sanine-a/iowa-rover/README.md

iowa-rover
==========

hardware & software for the new Iowa Mars rover exhibit.
