sanine-a/iowa-rover/kiosk/code/README.md

# kiosk/code

This folder contains three Arduino sketches used on the rover electronics.

  * `irkiosk-i2c-reset`: sketch for the ATTiny85 used to power-cycle the RFID modules
  * `irkiosk-main`: main sketch, for the Arduino Mega
  * `irkiosk-rfid-attiny`: sketch for the ATTiny84s on the RFID modules
