sanine-a/iowa-rover/rover/electronics/iowa-rover/README.md

Iowa Science Rover - Rover Controller
=====================================

The main controller board for the SMM revision of the Iowa Science Rover.

The Metro Mini listens for commands from the kiosk via the radio transceiver, and then executes
the received commands via the motors. The switch allows the controller to choose which kiosk it
listens to, and the trimpot allows maintenance technicians to correct for any directional drift due
to motor wear over time.

Parts
-----

 * [TB6612 Motor Driver](https://www.adafruit.com/product/2448)
 * [RFM69HCW Transceiver](https://www.adafruit.com/product/3070)
 * [Metro Mini v2](https://www.adafruit.com/product/2590)
 * [2k Trimpot](https://www.digikey.com/en/products/detail/bourns-inc/3352T-1-202LF/1088345)
 * [SPDT Switch](https://www.digikey.com/en/products/detail/bourns-inc/3352T-1-202LF/1088345)
 * [USB-C Power Connector](https://www.adafruit.com/product/4907)
 * [Screw Terminals](https://www.digikey.com/en/products/detail/molex/0398800302/2421325)
 * [Motors](https://www.adafruit.com/product/3802)
