sanine-a/iowa-rover/kiosk/electronics/iowa-rover-kiosk-lamps/iowa-rover-kiosk-lamps.pdf

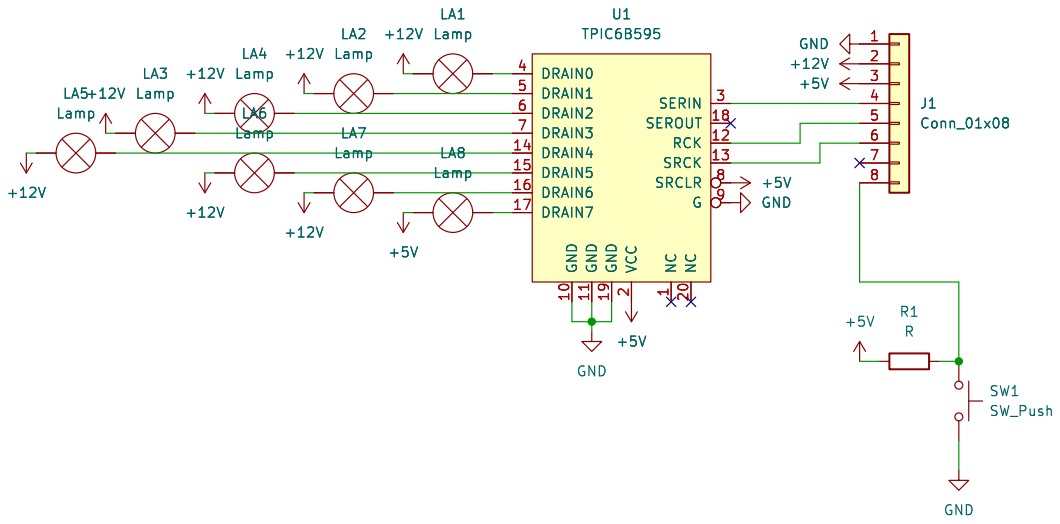
[picture p3: page 1]

1 GND 10 GND 11 RCK 12 SRCK DRAIN4 13

Id: 1/1 Title: Iowa Science Rover Kiosk - Lamps Board
