sanine-a/iowa-rover/kiosk/electronics/iowa-rover-kiosk-main/iowa-rover-kiosk-main.pdf

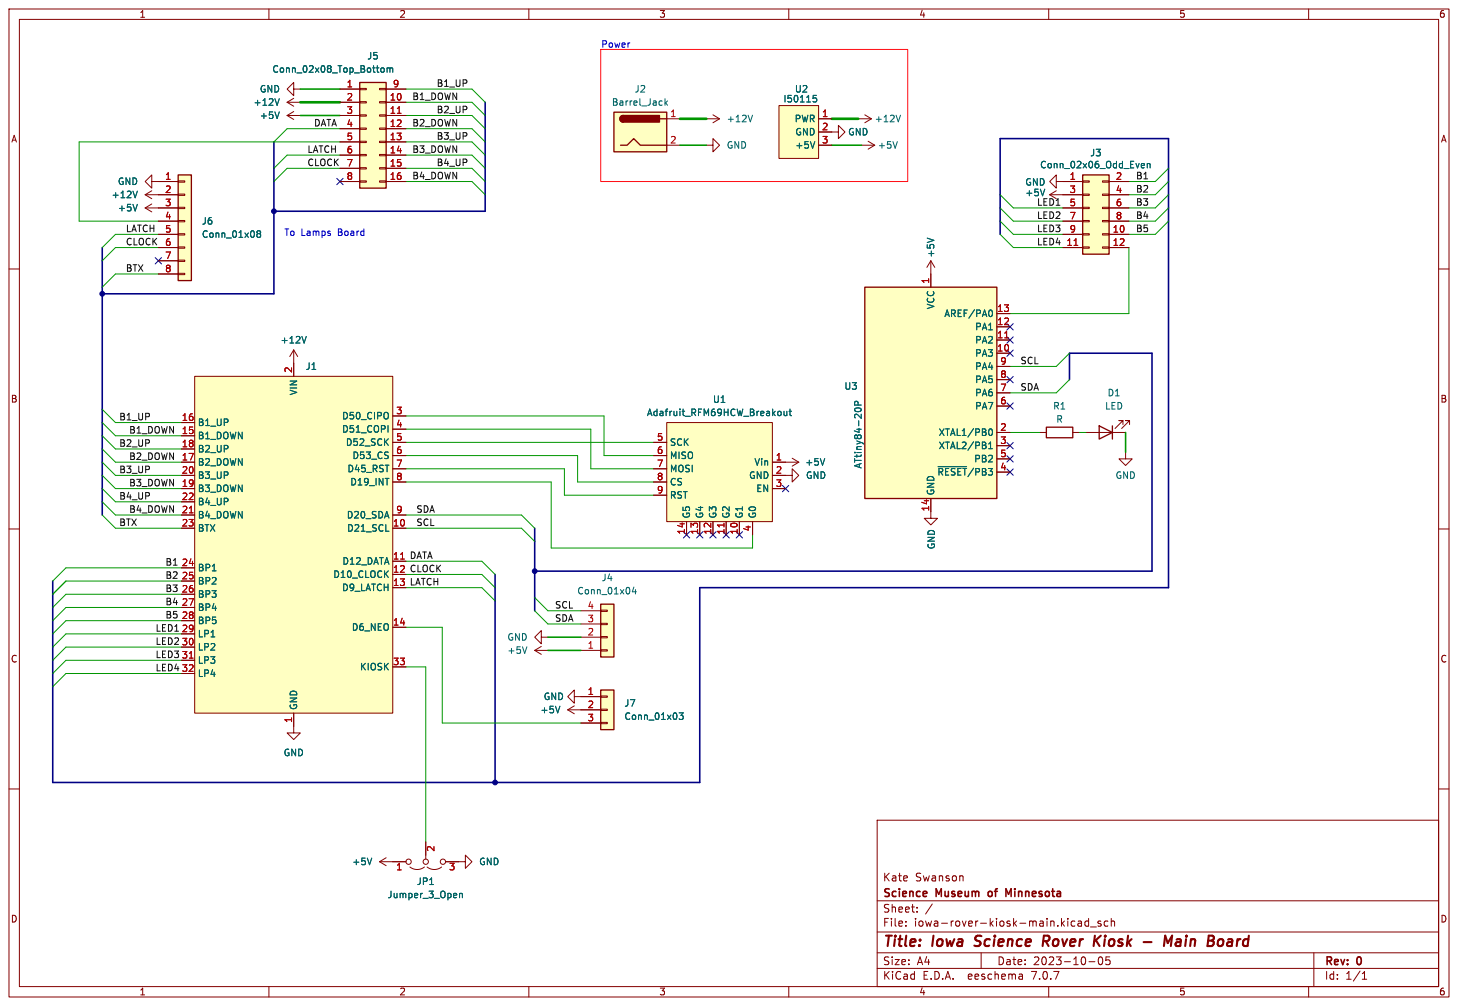
[picture p4: page 1]

4 SCK 5 MISO 6 MOSI 7 CS 8 RST 9 U1 Adafruit_RFM69HCW_Breakout +12V GND

4 SCK 5 MISO 6 MOSI 7 CS 8 RST 9

Id: 1/1 Title: Iowa Science Rover Kiosk - Main Board
