sanine-a/iowa-rover/kiosk/electronics/iowa-rover-kiosk-mega-adapter/iowa-rover-kiosk-mega-adapter.pdf

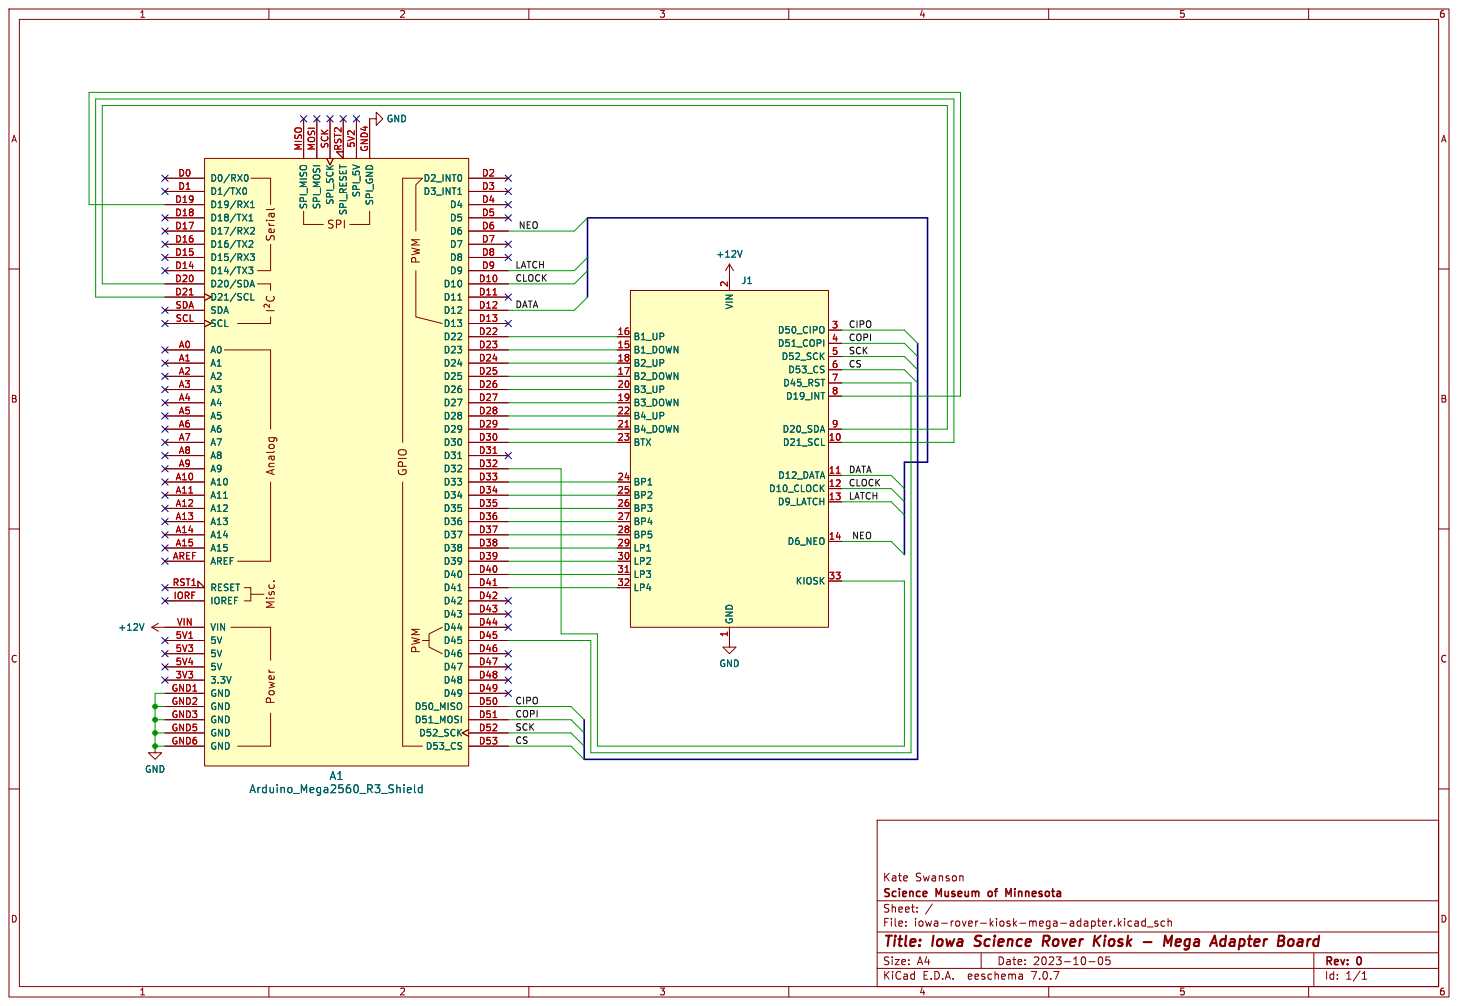
[picture p5: page 1]

Id: 1/1 Title: Iowa Science Rover Kiosk - Mega Adapter Board
