sanine-a/iowa-rover/kiosk/electronics/iowa-rover-kiosk-programmer/iowa-rover-kiosk-programmer.pdf

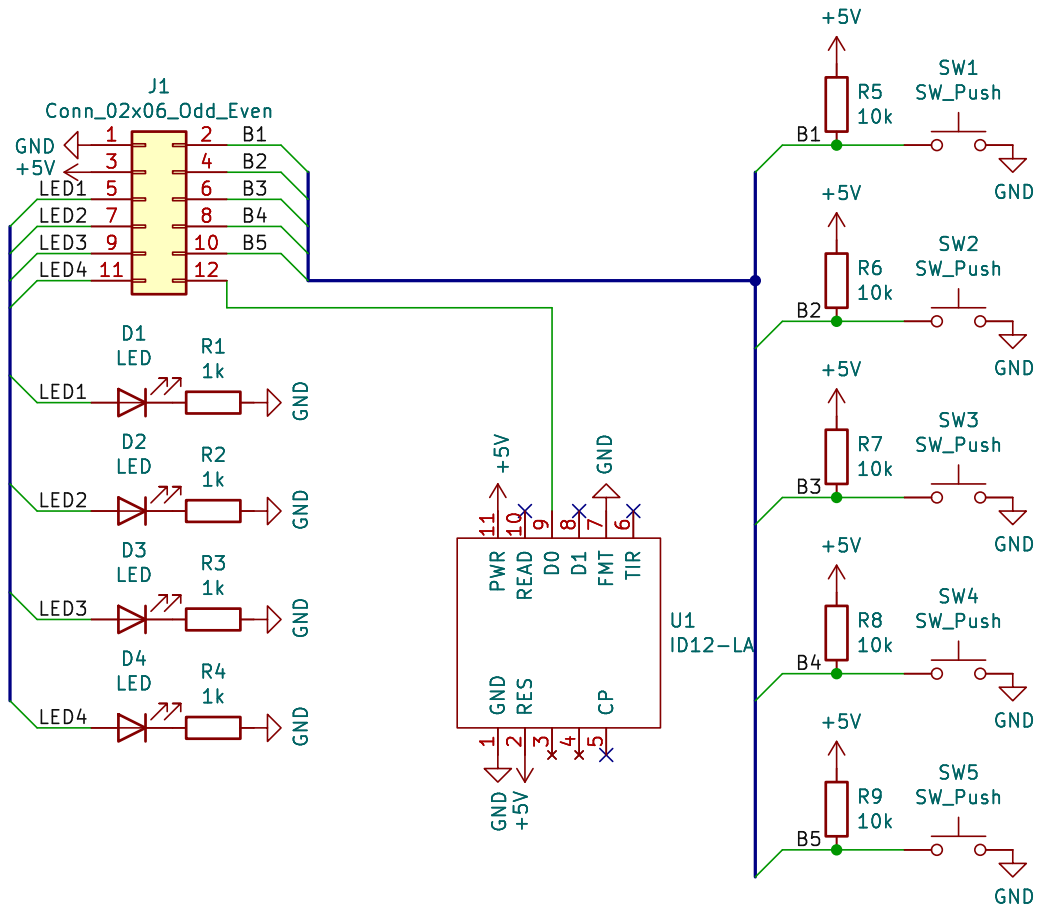
[picture p6: page 1]

Id: 1/1 Title: Iowa Science Rover Kiosk - RFID Programmer Board
