sanine-a/iowa-rover/kiosk/electronics/iowa-rover-kiosk-rfid/iowa-rover-kiosk-rfid.pdf

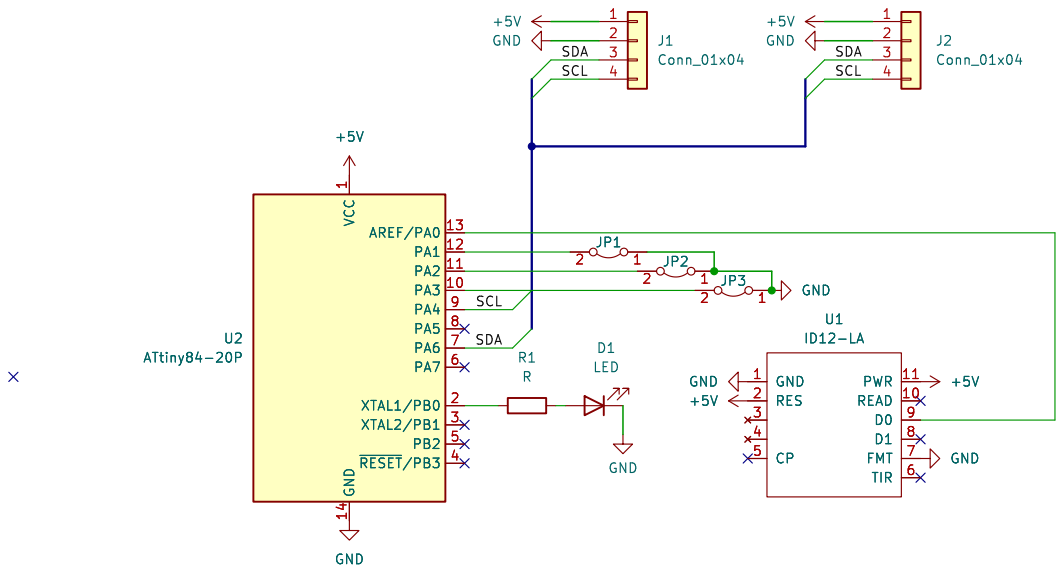
[picture p7: page 1]

1 PA3 10 PA2 11 PA1 12 AREF/PA0 13 GND 14 XTAL1/PB0 2 XTAL2/PB1 3 ~{RESET}/PB34 PB2 5 PA7 6 PA6 7 PA5 8 PA4 9 U2 ATtiny84-20P GND GND

1 PA3 10 PA2 11 PA1 12 AREF/PA0 13 GND 14 XTAL1/PB0 2 XTAL2/PB1 3 ~{RESET}/PB34 PB2 5 PA7 6 PA6 7 PA5 8 PA4 9 GND

Id: 1/1 Title: Iowa Rover Kiosk - RFID Board
