sanine-a/iowa-rover/rover/electronics/iowa-rover/iowa-rover.pdf

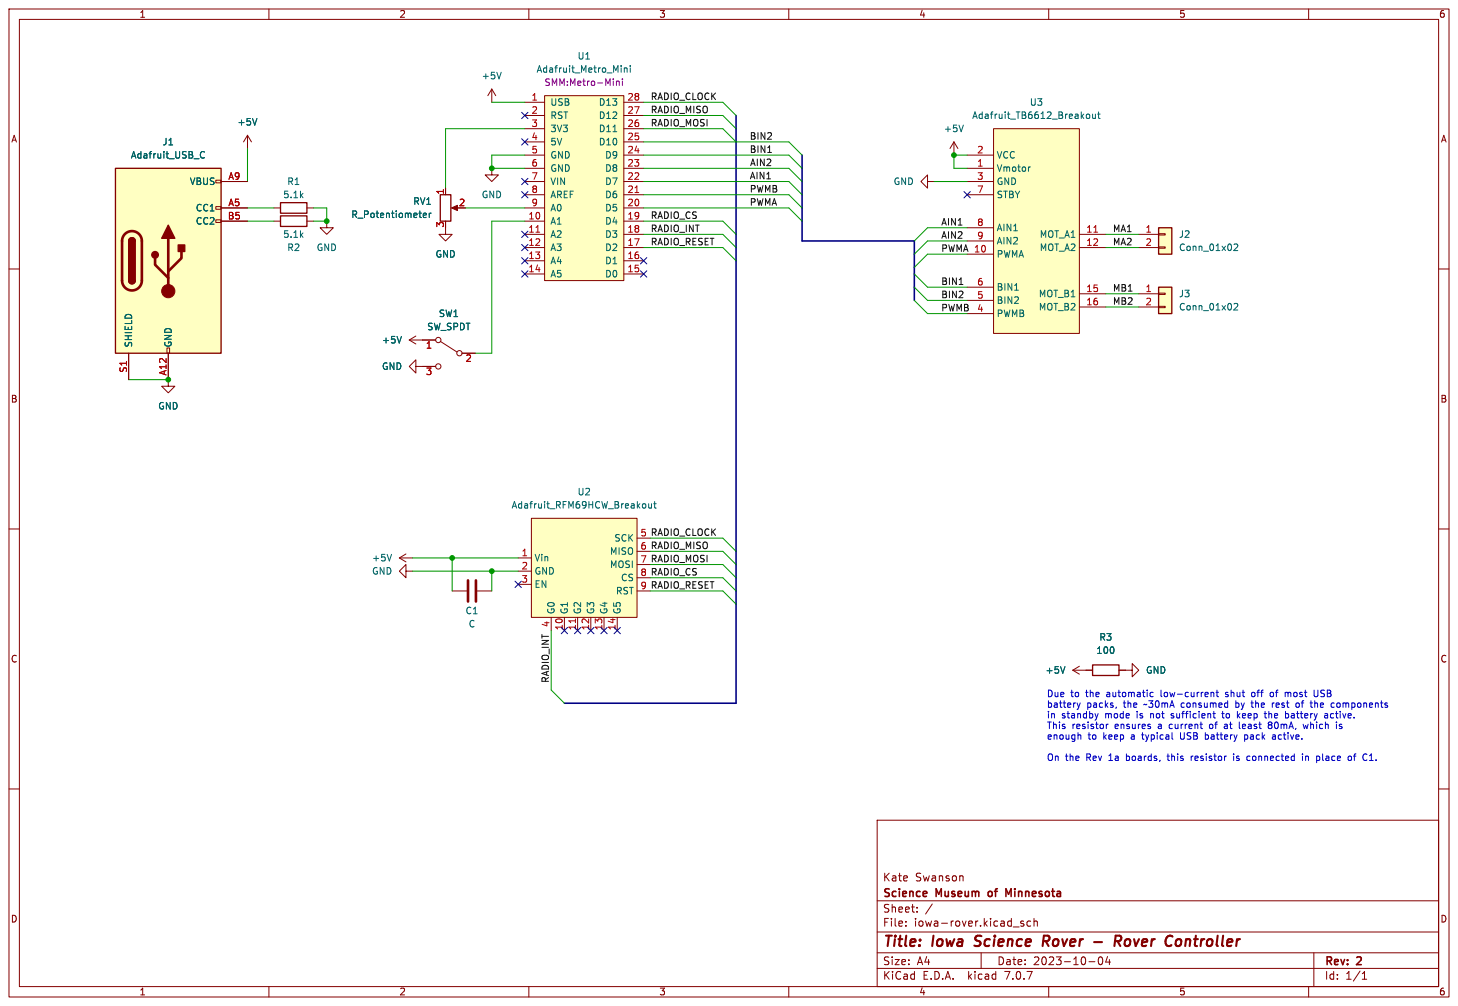
[picture p8: page 1]

4 SCK 5 MISO 6 MOSI 7 CS 8 RST 9 U2 Adafruit_RFM69HCW_Breakout BIN1 RADIO_MISO
