sanine-a/iowa-rover/kiosk/electronics/iowa-rover-kiosk-power-cycler/iowa-rover-kiosk-power-cycler.kicad_pcb

## KiCad design kiosk/electronics/iowa-rover-kiosk-power-cycler/iowa-rover-kiosk-power-cycler.kicad_pcb (2023-10-26)

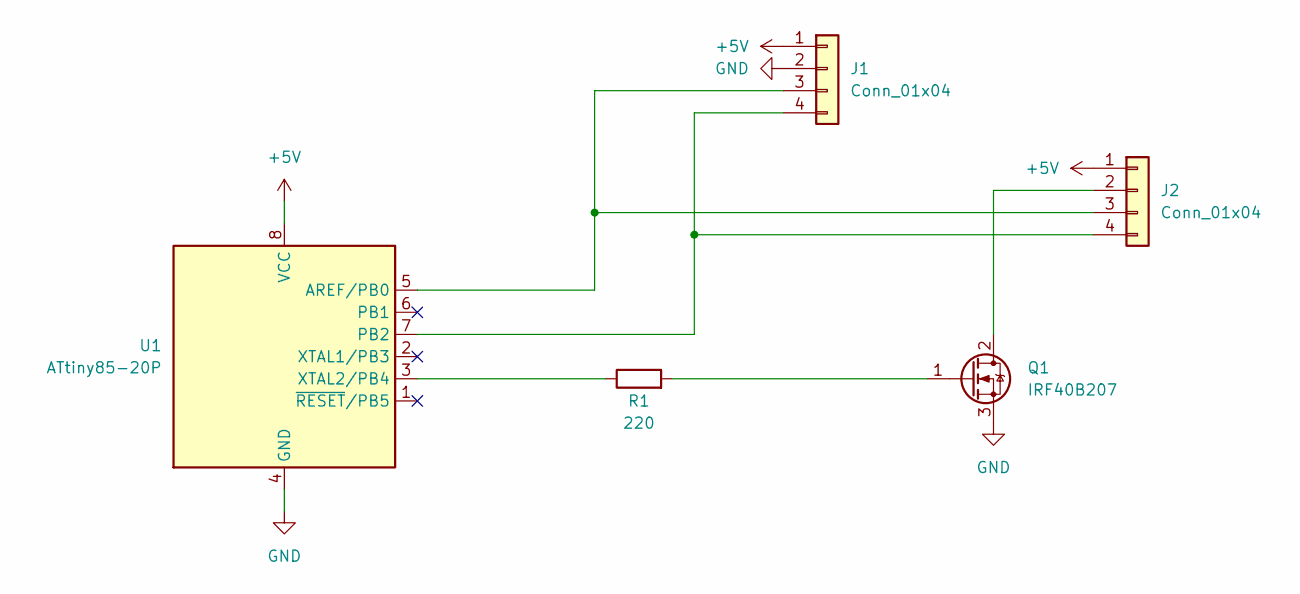
[picture p9: schematic iowa-rover-kiosk-power-cycler.kicad_sch]

Parts:
J1, J2: Conn_01x04; Molex_KK-254_AE-6410-04A_1x04_P2.54mm_Vertical
Q1: IRF40B207; TO-220-3_Vertical
R1: 220; R_Axial_DIN0207_L6.3mm_D2.5mm_P7.62mm_Horizontal
U1: ATtiny85-20P; DIP-8_W7.62mm

Connections:
+5V: J1.1, J2.1, U1.8 (VCC)
GND: J1.2, Q1.3 (S), U1.4 (GND)
unnamed: J1.3, J2.3, U1.5 (AREF/PB0)
unnamed: J1.4, J2.4, U1.7 (PB2)
unnamed: J2.2, Q1.2 (D)
unnamed: Q1.1 (G), R1.2
unnamed: R1.1, U1.3 (XTAL2/PB4)

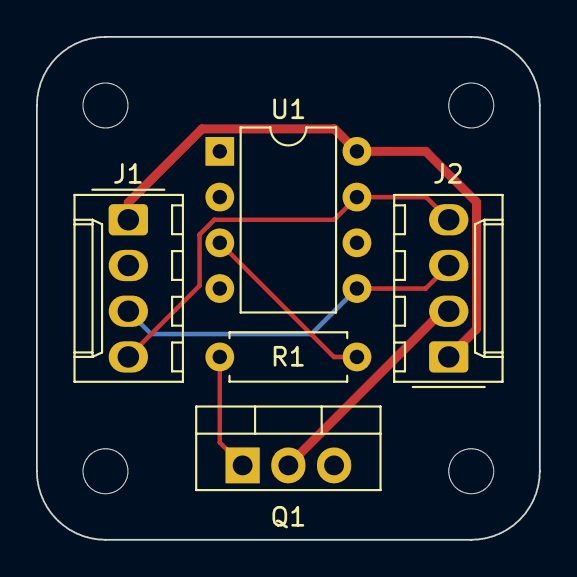
[picture p10: board iowa-rover-kiosk-power-cycler.kicad_pcb from above]

Board: 2 copper layers, 27.9 x 27.9 mm, 5 parts (0 on the bottom side), 7 nets.
