sanine-a/iowa-rover/rover/electronics/iowa-rover/iowa-rover.kicad_pcb

## KiCad design rover/electronics/iowa-rover/iowa-rover.kicad_pcb (2023-10-03)

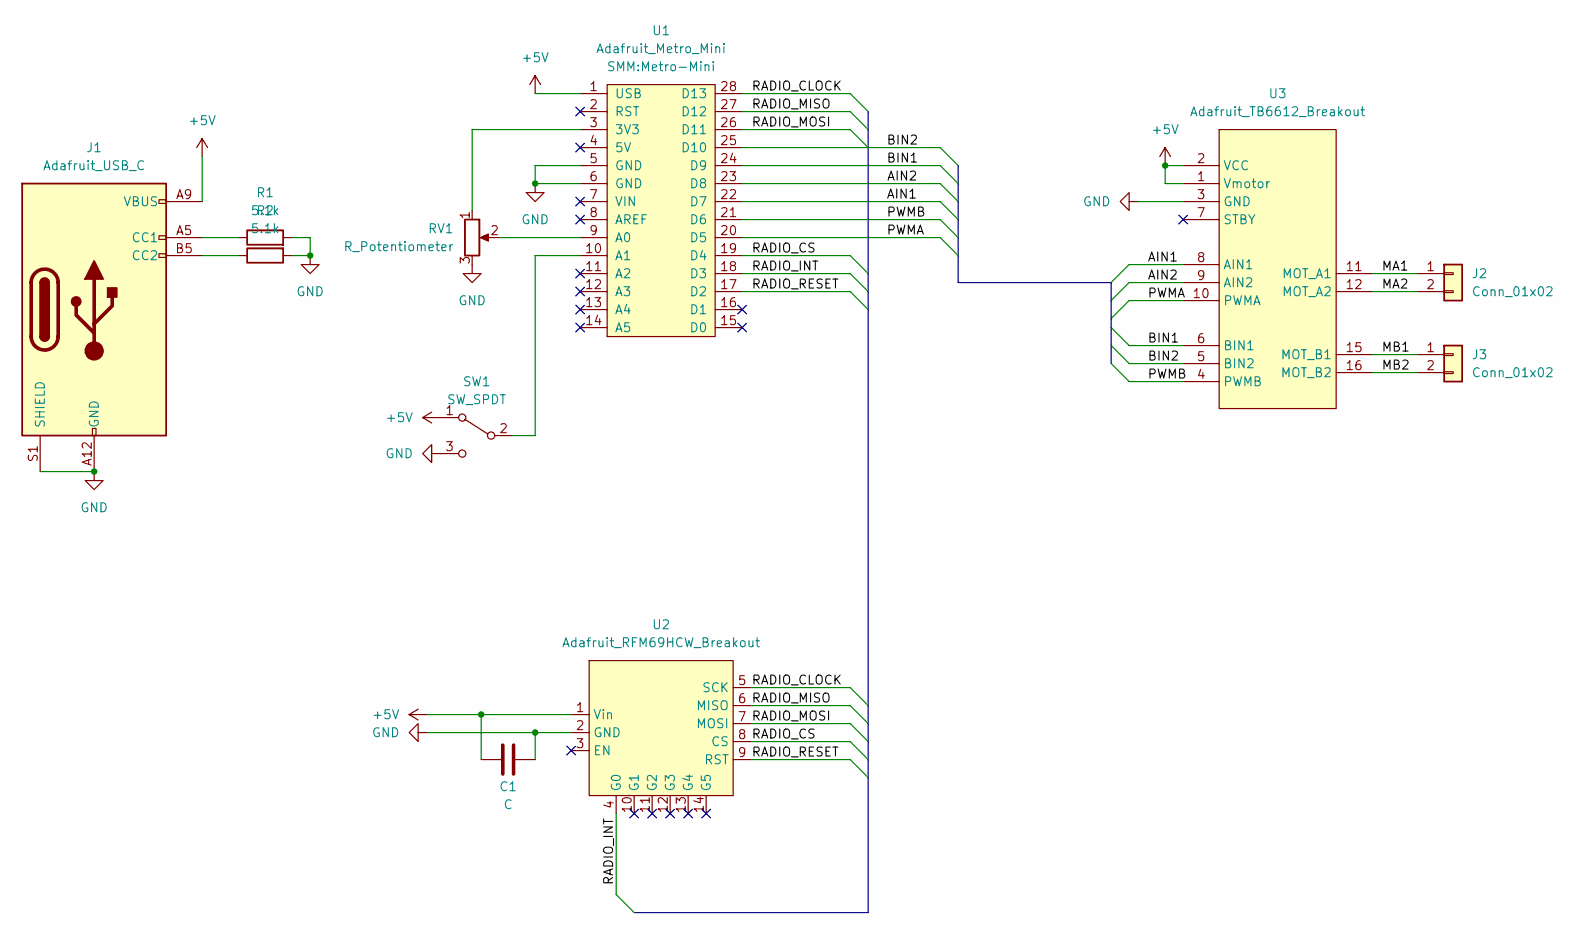
[picture p11: schematic iowa-rover.kicad_sch]

Parts:
C1: C; C_Disc_D4.3mm_W1.9mm_P5.00mm
J1: Adafruit_USB_C
J2, J3: Conn_01x02; TerminalBlock-2_P5.08mm_small
R1, R2: 5.1k; Resistor_L6.3mm_D2.5mm_P10.16mm_Horizontal
RV1: R_Potentiometer; Rover_Trimpot
SW1: SW_SPDT; SW_EG1218
U1: Adafruit_Metro_Mini; Metro-Mini
U2: Adafruit_RFM69HCW_Breakout; Adafruit RFM69HCW Breakout
U3: Adafruit_TB6612_Breakout

Connections:
+5V: C1.1, J1.A9 (VBUS), J1.B9 (VBUS), SW1.1 (A), U1.1 (USB), U2.1 (Vin), U3.1 (Vmotor), U3.2 (VCC)
/AIN1: U1.22 (D7), U3.8 (AIN1)
/AIN2: U1.23 (D8), U3.9 (AIN2)
/BIN1: U1.24 (D9), U3.6 (BIN1)
/BIN2: U1.25 (D10), U3.5 (BIN2)
/MA1: J2.1, U3.11 (MOT_A1)
/MA2: J2.2, U3.12 (MOT_A2)
/MB1: J3.1, U3.15 (MOT_B1)
/MB2: J3.2, U3.16 (MOT_B2)
/PWMA: U1.20 (D5), U3.10 (PWMA)
/PWMB: U1.21 (D6), U3.4 (PWMB)
/RADIO_CLOCK: U1.28 (D13), U2.5 (SCK)
/RADIO_CS: U1.19 (D4), U2.8 (CS)
/RADIO_INT: U1.18 (D3), U2.4 (G0)
/RADIO_MISO: U1.27 (D12), U2.6 (MISO)
/RADIO_MOSI: U1.26 (D11), U2.7 (MOSI)
/RADIO_RESET: U1.17 (D2), U2.9 (RST)
GND: C1.2, J1.A12 (GND), J1.B12 (GND), J1.S1 (SHIELD), R1.2, R2.2, RV1.3, SW1.3 (C), U1.5 (GND), U1.6 (GND), U2.2 (GND), U3.3 (GND), U3.13 (GND), U3.14 (GND)
unnamed: J1.A5 (CC1), R1.1
unnamed: J1.B5 (CC2), R2.1
unnamed: SW1.2 (B), U1.10 (A1)
unnamed: RV1.1, U1.3 (3V3)
unnamed: RV1.2, U1.9 (A0)

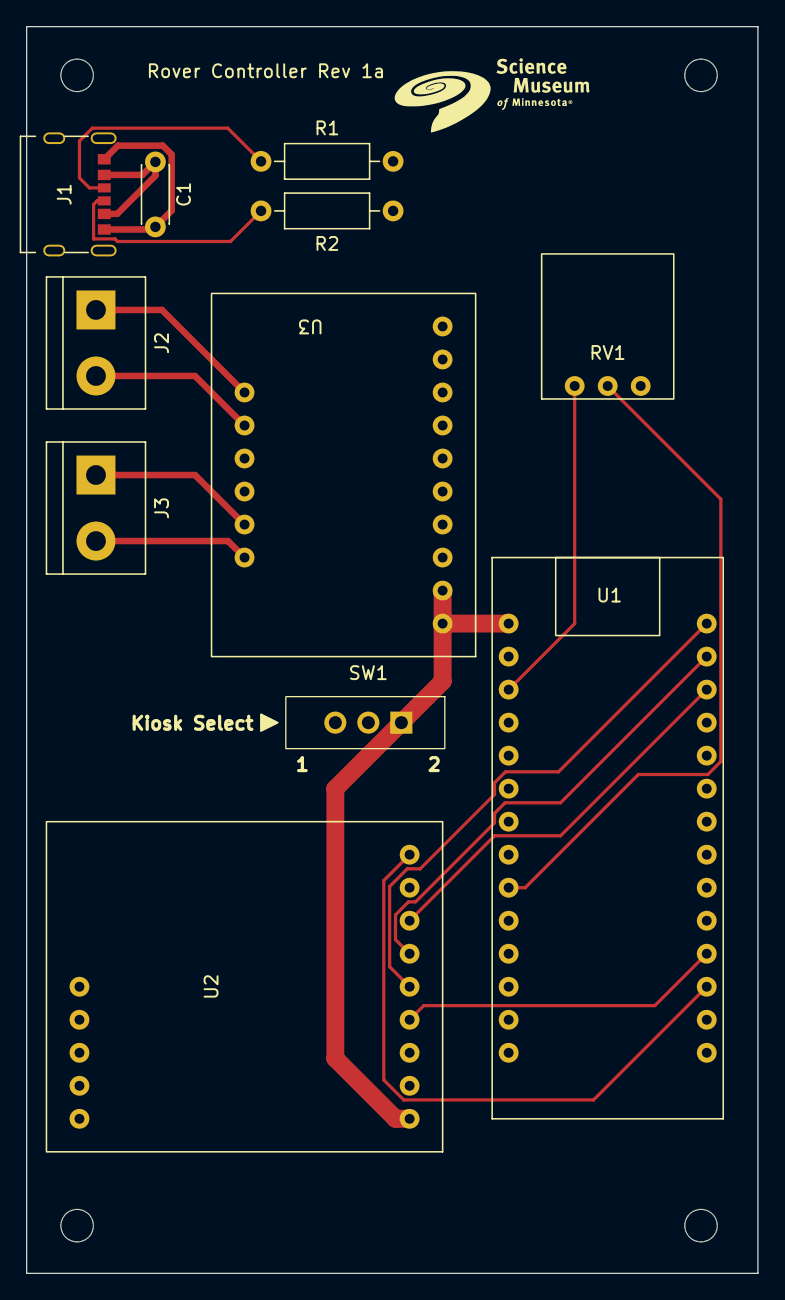
[picture p12: board iowa-rover.kicad_pcb from above]

Board: 4 copper layers, 56.3 x 95.9 mm, 11 parts (0 on the bottom side), 23 nets.
