sanine-a/iowa-rover/kiosk/electronics/iowa-rover-kiosk-rfid/iowa-rover-kiosk-rfid.kicad_pcb

## KiCad design kiosk/electronics/iowa-rover-kiosk-rfid/iowa-rover-kiosk-rfid.kicad_pcb (2023-10-03)

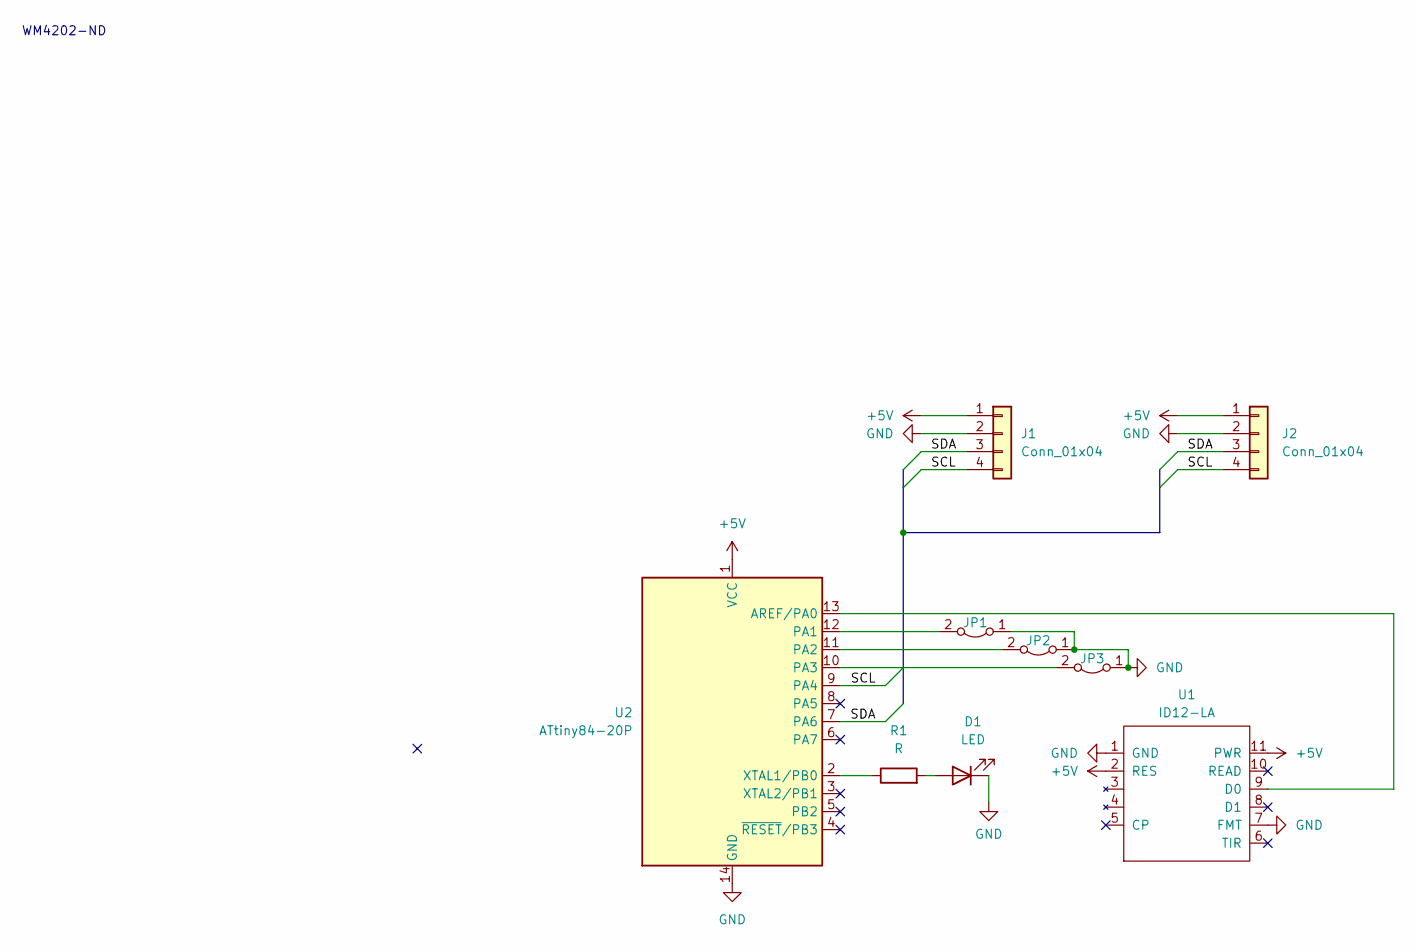
[picture p13: schematic iowa-rover-kiosk-rfid.kicad_sch]

Parts:
D1: LED; LED_D3.0mm
J1, J2: Conn_01x04; KK-1x04
JP1, JP2, JP3: Jumper_2_Bridged; SolderJumper-2_P1.3mm_Bridged_RoundedPad1.0x1.5mm
R1: R; Resistor_L6.3mm_D2.5mm_P10.16mm_Horizontal
U1: ID12-LA; ID-12LA-Inverted
U2: ATtiny84-20P; DIP-14_W7.62mm

Connections:
+5V: J1.1, J2.1, U1.2 (RES), U1.11 (PWR), U2.1 (VCC)
/SCL: J1.4, J2.4, U2.9 (PA4)
/SDA: J1.3, J2.3, U2.7 (PA6)
GND: D1.1 (K), J1.2, J2.2, JP1.1 (A), JP2.1 (A), JP3.1 (A), U1.1 (GND), U1.7 (FMT), U2.14 (GND)
unnamed: D1.2 (A), R1.2
unnamed: JP1.2 (B), U2.12 (PA1)
unnamed: JP2.2 (B), U2.11 (PA2)
unnamed: JP3.2 (B), U2.10 (PA3)
unnamed: U1.9 (D0), U2.13 (AREF/PA0)
unnamed: R1.1, U2.2 (XTAL1/PB0)

Notes on the sheet:
WM4202-ND

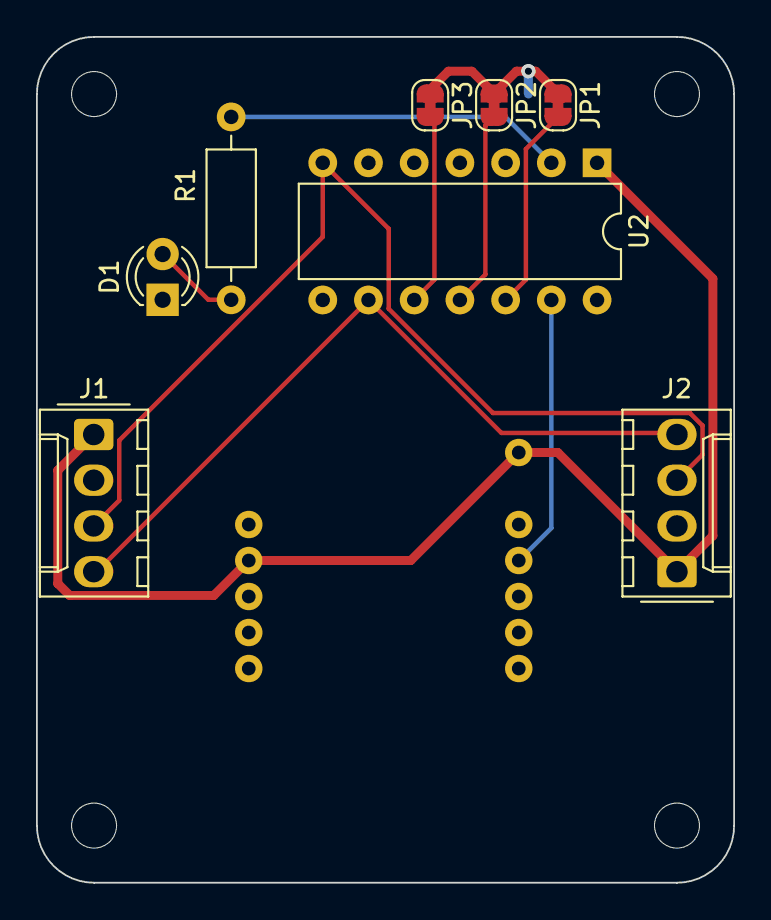
[picture p14: board iowa-rover-kiosk-rfid.kicad_pcb from above]

Board: 2 copper layers, 38.7 x 47.0 mm, 9 parts (0 on the bottom side), 10 nets.
