sanine-a/iowa-rover/kiosk/electronics/iowa-rover-kiosk-programmer/iowa-rover-kiosk-programmer.kicad_pcb

## KiCad design kiosk/electronics/iowa-rover-kiosk-programmer/iowa-rover-kiosk-programmer.kicad_pcb (2023-10-03)

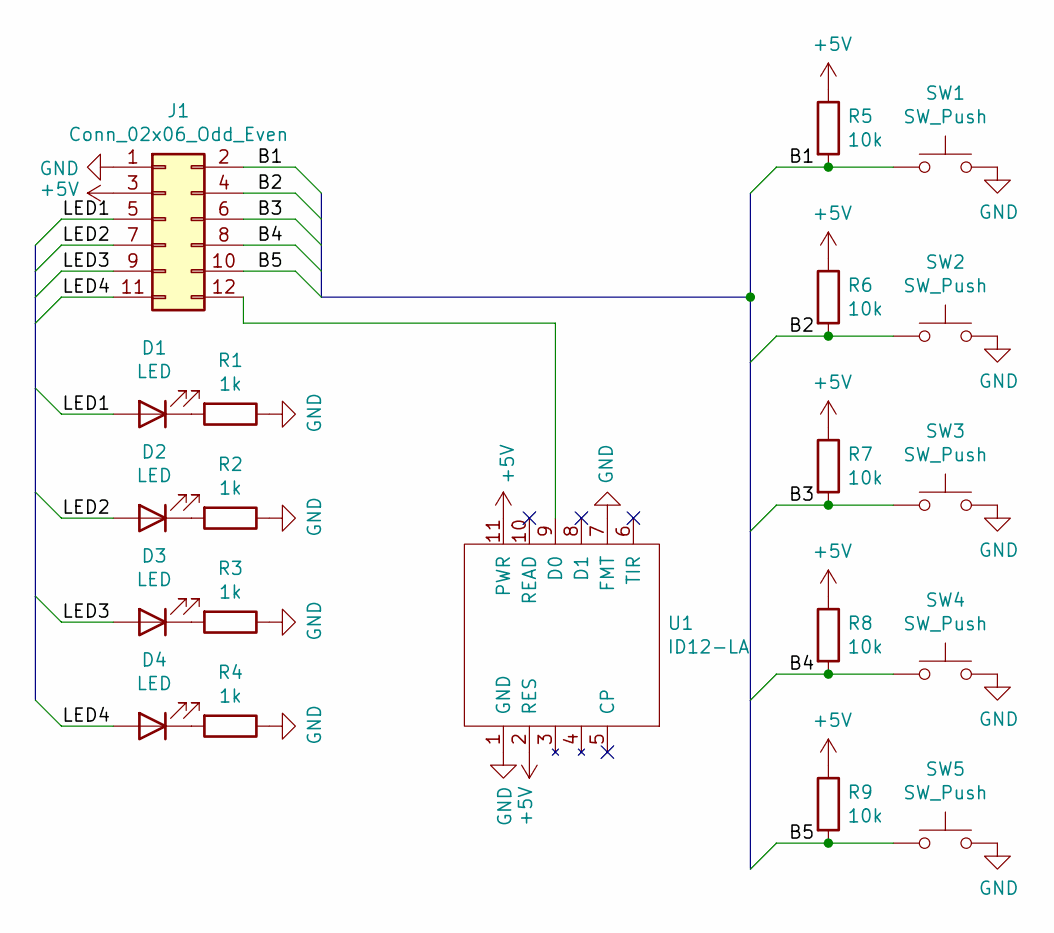
[picture p15: schematic iowa-rover-kiosk-programmer.kicad_sch]

Parts:
D1, D2, D3, D4: LED; LED_D3.0mm
J1: Conn_02x06_Odd_Even; PinHeader_2x06_P2.54mm_Vertical
R1, R2, R3, R4: 1k; R_Axial_DIN0207_L6.3mm_D2.5mm_P10.16mm_Horizontal
R5, R6, R7, R8, R9: 10k; R_Axial_DIN0207_L6.3mm_D2.5mm_P10.16mm_Horizontal
SW1, SW2, SW3, SW4, SW5: SW_Push; SW_PUSH_6mm_H4.3mm
U1: ID12-LA; ID-12LA

Connections:
+5V: J1.3, R5.1, R6.1, R7.1, R8.1, R9.1, U1.2 (RES), U1.11 (PWR)
/B1: J1.2, R5.2, SW1.1
/B2: J1.4, R6.2, SW2.1
/B3: J1.6, R7.2, SW3.1
/B4: J1.8, R8.2, SW4.1
/B5: J1.10, R9.2, SW5.1
/LED1: D1.2 (A), J1.5
/LED2: D2.2 (A), J1.7
/LED3: D3.2 (A), J1.9
/LED4: D4.2 (A), J1.11
GND: J1.1, R1.1, R2.1, R3.1, R4.1, SW1.2, SW2.2, SW3.2, SW4.2, SW5.2, U1.1 (GND), U1.7 (FMT)
unnamed: D1.1 (K), R1.2
unnamed: D2.1 (K), R2.2
unnamed: D3.1 (K), R3.2
unnamed: D4.1 (K), R4.2
unnamed: J1.12, U1.9 (D0)

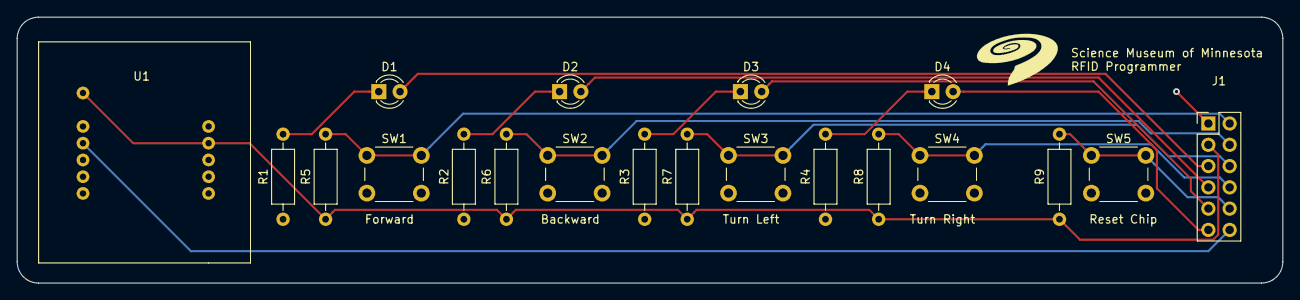
[picture p16: board iowa-rover-kiosk-programmer.kicad_pcb from above]

Board: 2 copper layers, 151.1 x 31.8 mm, 20 parts (0 on the bottom side), 16 nets.
