sanine-a/iowa-rover/kiosk/electronics/iowa-rover-kiosk-lamps/iowa-rover-kiosk-lamps.kicad_pcb

## KiCad design kiosk/electronics/iowa-rover-kiosk-lamps/iowa-rover-kiosk-lamps.kicad_pcb (2023-10-03)

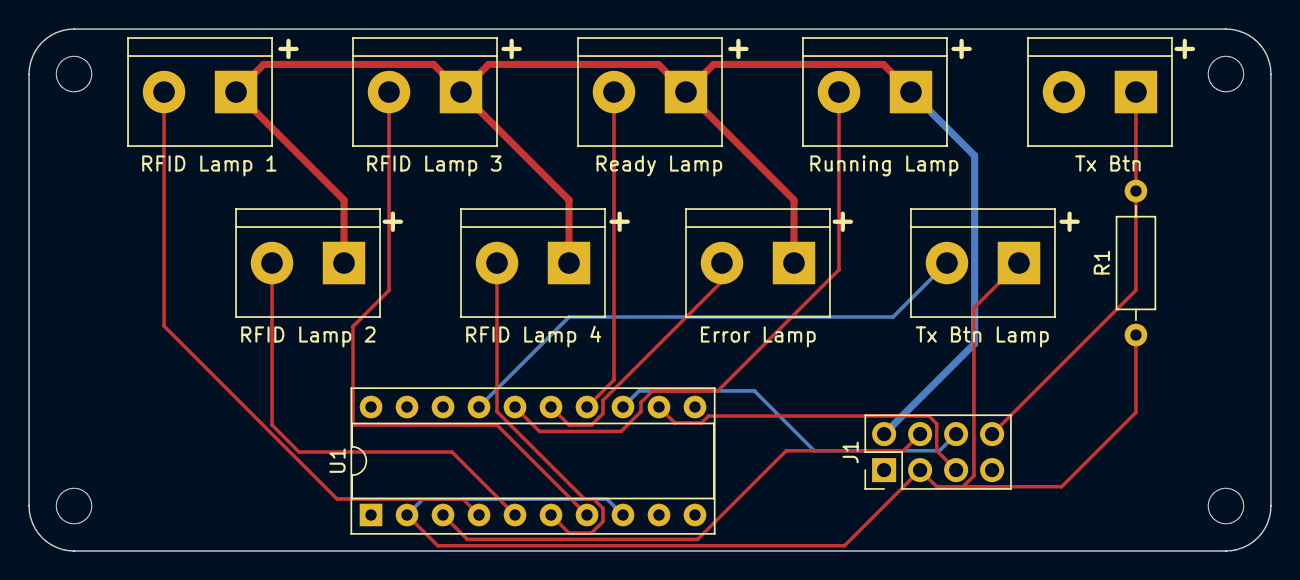
[picture p17: board iowa-rover-kiosk-lamps.kicad_pcb from above]

Board: 2 copper layers, 87.6 x 36.8 mm, 12 parts (0 on the bottom side), 15 nets.

Parts:
Error Lamp: Lamp; TerminalBlock-2_P5.08mm_small
J1: Conn_01x08; PinHeader_2x04_P2.54mm_Vertical
R1: R; Resistor_L6.3mm_D2.5mm_P10.16mm_Horizontal
RFID Lamp 1, RFID Lamp 2, RFID Lamp 3, RFID Lamp 4: Lamp; TerminalBlock-2_P5.08mm_small
Ready Lamp: Lamp; TerminalBlock-2_P5.08mm_small
Running Lamp: Lamp; TerminalBlock-2_P5.08mm_small
Tx Btn: SW_Push; TerminalBlock-2_P5.08mm_small
Tx Btn Lamp: Lamp; TerminalBlock-2_P5.08mm_small
U1: TPIC6B595; DIP-20_W7.62mm_Socket

Connections:
+5V: J1.3, R1.1, Tx Btn Lamp.1 (-), U1.2 (VCC), U1.8 (SRCLR)
+12V: Error Lamp.1 (-), J1.2, RFID Lamp 1.1 (-), RFID Lamp 2.1 (-), RFID Lamp 3.1 (-), RFID Lamp 4.1 (-), Ready Lamp.1 (-), Running Lamp.1 (-)
GND: J1.1, Tx Btn.2, U1.9 (G), U1.10 (GND), U1.11 (GND), U1.19 (GND)
unnamed: J1.4, U1.3 (SERIN)
unnamed: J1.5, U1.12 (RCK)
unnamed: J1.6, U1.13 (SRCK)
unnamed: J1.8, R1.2, Tx Btn.1
unnamed: RFID Lamp 1.2 (+), U1.4 (DRAIN0)
unnamed: RFID Lamp 2.2 (+), U1.5 (DRAIN1)
unnamed: RFID Lamp 3.2 (+), U1.7 (DRAIN3)
unnamed: RFID Lamp 4.2 (+), U1.6 (DRAIN2)
unnamed: Ready Lamp.2 (+), U1.14 (DRAIN4)
unnamed: Error Lamp.2 (+), U1.15 (DRAIN5)
unnamed: Running Lamp.2 (+), U1.16 (DRAIN6)
unnamed: Tx Btn Lamp.2 (+), U1.17 (DRAIN7)
