sanine-a/iowa-rover/kiosk/electronics/iowa-rover-kiosk-level-buttons/iowa-rover-kiosk-level-buttons.kicad_pcb

## KiCad design kiosk/electronics/iowa-rover-kiosk-level-buttons/iowa-rover-kiosk-level-buttons.kicad_pcb (2023-10-03)

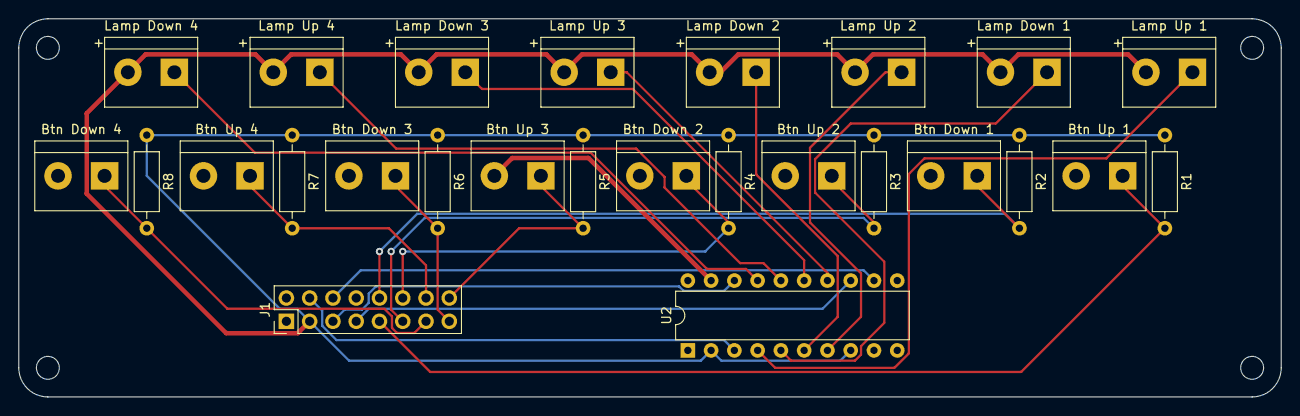
[picture p18: board iowa-rover-kiosk-level-buttons.kicad_pcb from above]

Board: 2 copper layers, 137.8 x 41.3 mm, 26 parts (0 on the bottom side), 22 nets.

Parts:
Btn Down 1, Btn Down 2, Btn Down 3, Btn Down 4: SW_Push; TerminalBlock-2_P5.08mm_small
Btn Up 1, Btn Up 2, Btn Up 3, Btn Up 4: SW_Push; TerminalBlock-2_P5.08mm_small
J1: Conn_02x08_Top_Bottom; PinHeader_2x08_P2.54mm_Vertical
Lamp Down 1, Lamp Down 2, Lamp Down 3, Lamp Down 4: Lamp; TerminalBlock-2_P5.08mm_small
Lamp Up 1, Lamp Up 2, Lamp Up 3, Lamp Up 4: Lamp; TerminalBlock-2_P5.08mm_small
R1, R2, R3, R4, R5, R6, R7, R8: R; Resistor_L6.3mm_D2.5mm_P10.16mm_Horizontal
U2: TPIC6B595; DIP-20_W7.62mm

Connections:
+5V: J1.3, Lamp Down 1.2 (+), Lamp Down 2.2 (+), Lamp Down 3.2 (+), Lamp Down 4.2 (+), Lamp Up 1.2 (+), Lamp Up 2.2 (+), Lamp Up 3.2 (+), Lamp Up 4.2 (+), R1.1, R2.1, R3.1, R4.1, R5.1, R6.1, R7.1, R8.1, U2.2 (VCC), U2.8 (SRCLR)
/CIPO: J1.5, U2.18 (SEROUT)
/CLOCK: J1.7, U2.13 (SRCK)
/COPI: J1.4, U2.3 (SERIN)
/LATCH: J1.6, U2.12 (RCK)
GND: Btn Down 1.2, Btn Down 2.2, Btn Down 3.2, Btn Down 4.2, Btn Up 1.2, Btn Up 2.2, Btn Up 3.2, Btn Up 4.2, J1.1, U2.9 (G), U2.10 (GND), U2.11 (GND), U2.19 (GND)
unnamed: Btn Up 1.1, J1.9, R1.2
unnamed: Btn Down 1.1, J1.10, R2.2
unnamed: Btn Up 2.1, J1.11, R3.2
unnamed: Btn Down 2.1, J1.12, R4.2
unnamed: Btn Down 4.1, J1.13, R8.2
unnamed: Btn Up 4.1, J1.14, R7.2
unnamed: Btn Down 3.1, J1.15, R6.2
unnamed: Btn Up 3.1, J1.16, R5.2
unnamed: Lamp Up 1.1 (-), U2.4 (DRAIN0)
unnamed: Lamp Down 1.1 (-), U2.5 (DRAIN1)
unnamed: Lamp Up 2.1 (-), U2.7 (DRAIN3)
unnamed: Lamp Down 2.1 (-), U2.6 (DRAIN2)
unnamed: Lamp Up 3.1 (-), U2.14 (DRAIN4)
unnamed: Lamp Down 3.1 (-), U2.15 (DRAIN5)
unnamed: Lamp Up 4.1 (-), U2.16 (DRAIN6)
unnamed: Lamp Down 4.1 (-), U2.17 (DRAIN7)
