sanine-a/iowa-rover/kiosk/electronics/iowa-rover-kiosk-main/iowa-rover-kiosk-main.kicad_pcb

## KiCad design kiosk/electronics/iowa-rover-kiosk-main/iowa-rover-kiosk-main.kicad_pcb (2023-10-03)

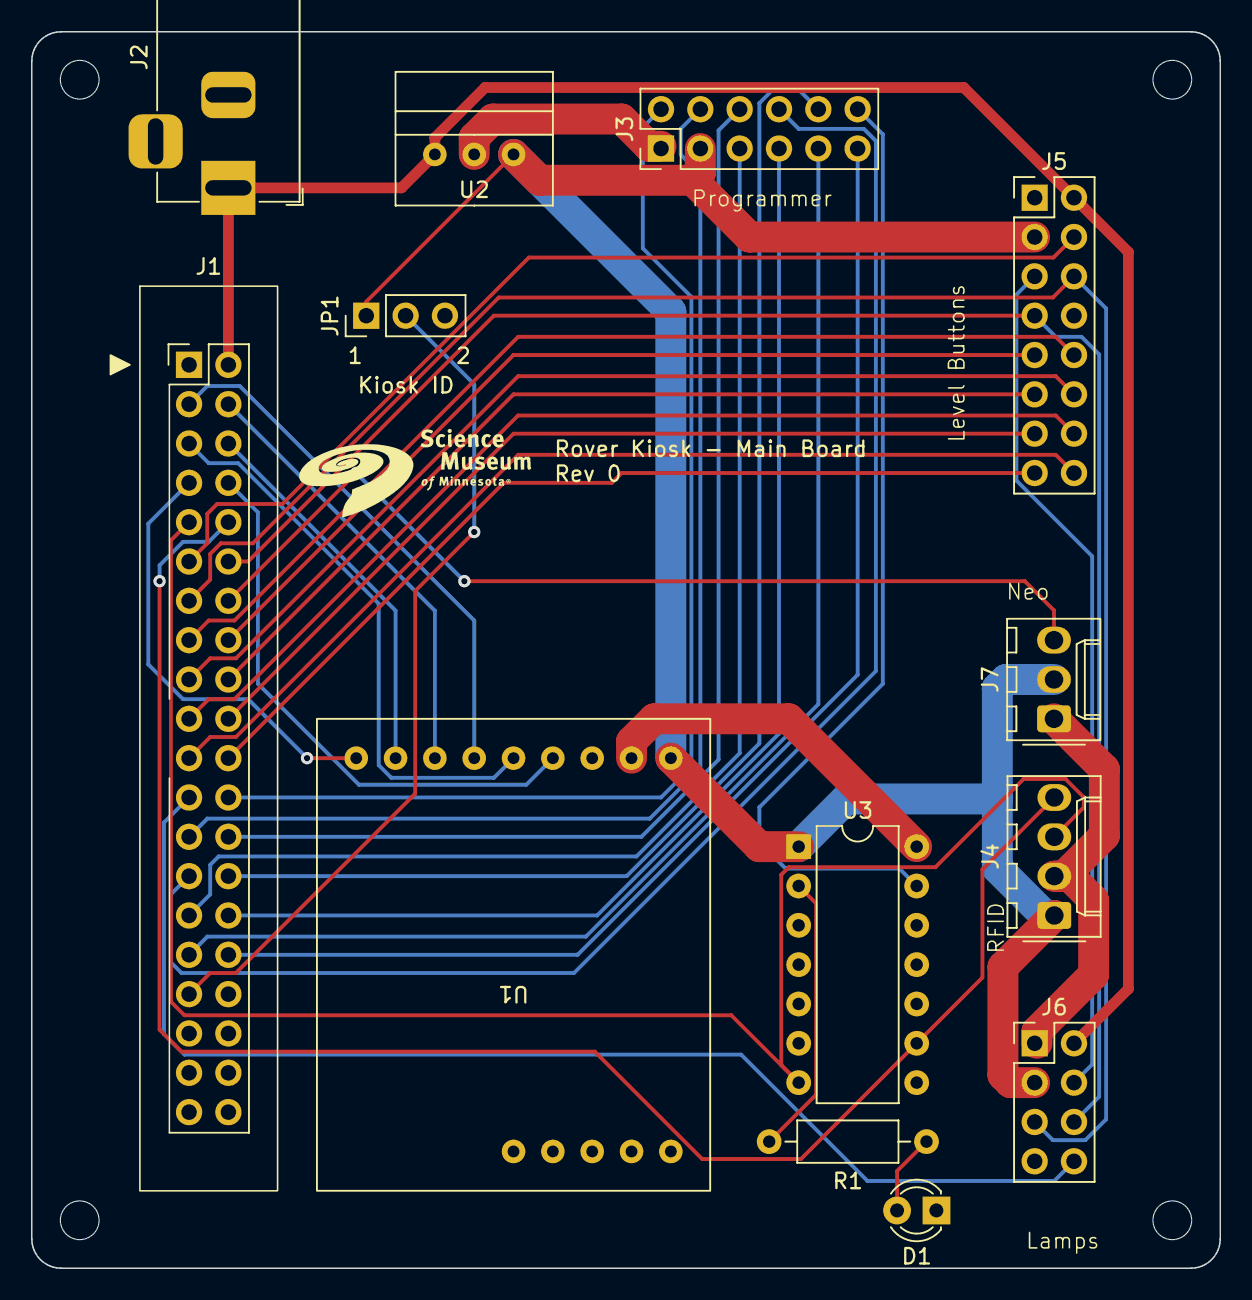
[picture p19: board iowa-rover-kiosk-main.kicad_pcb from above]

Board: 2 copper layers, 76.8 x 79.9 mm, 13 parts (0 on the bottom side), 38 nets.

Parts:
D1: LED; LED_D3.0mm
J1: PinHeader_2x20_Ribbon
J2: Barrel_Jack; BarrelJack_Horizontal
J3: Conn_02x06_Odd_Even; PinHeader_2x06_P2.54mm_Vertical
J4: Conn_01x04; Molex_KK-254_AE-6410-04A_1x04_P2.54mm_Vertical
J5: Conn_02x08_Top_Bottom; PinHeader_2x08_P2.54mm_Vertical
J6: Conn_01x08; PinHeader_2x04_P2.54mm_Vertical
J7: Conn_01x03; Molex_KK-254_AE-6410-03A_1x03_P2.54mm_Vertical
JP1: Jumper_3_Open; PinHeader_1x03_P2.54mm_Vertical
R1: R; Resistor_L6.3mm_D2.5mm_P10.16mm_Horizontal
U1: Adafruit_RFM69HCW_Breakout; Adafruit RFM69HCW Breakout
U2: I50115
U3: ATtiny84-20P; DIP-14_W7.62mm

Connections:
+5V: J3.3, J4.1, J5.3, J6.3, J7.2, JP1.1 (A), U1.1 (Vin), U2.3 (+5V), U3.1 (VCC)
+12V: J1.2 (VIN), J2.1, J5.2, J6.2, U2.1 (PWR)
/B1: J1.24 (BP1), J3.2
/B1_DOWN: J1.15 (B1_DOWN), J5.10
/B1_UP: J1.16 (B1_UP), J5.9
/B2: J1.25 (BP2), J3.4
/B2_DOWN: J1.17 (B2_DOWN), J5.12
/B2_UP: J1.18 (B2_UP), J5.11
/B3: J1.26 (BP3), J3.6
/B3_DOWN: J1.19 (B3_DOWN), J5.14
/B3_UP: J1.20 (B3_UP), J5.13
/B4: J1.27 (BP4), J3.8
/B4_DOWN: J1.21 (B4_DOWN), J5.16
/B4_UP: J1.22 (B4_UP), J5.15
/B5: J1.28 (BP5), J3.10
/BTX: J1.23 (BTX), J6.8
/CLOCK: J1.12 (D10_CLOCK), J5.7, J6.6
/DATA: J1.11 (D12_DATA), J5.4
/LATCH: J1.13 (D9_LATCH), J5.6, J6.5
/LED1: J1.29 (LP1), J3.5
/LED2: J1.30 (LP2), J3.7
/LED3: J1.31 (LP3), J3.9
/LED4: J1.32 (LP4), J3.11
/SCL: J1.10 (D21_SCL), J4.4, U3.9 (PA4)
/SDA: J1.9 (D20_SDA), J4.3, U3.7 (PA6)
GND: D1.1 (K), J1.1 (GND), J2.2, J3.1, J4.2, J5.1, J6.1, J7.1, JP1.3 (B), U1.2 (GND), U2.2 (GND), U3.14 (GND)
unnamed: D1.2 (A), R1.2
unnamed: J1.14 (D6_NEO), J7.3
unnamed: J1.8 (D19_INT), U1.4 (G0)
unnamed: J1.7 (D45_RST), U1.9 (RST)
unnamed: J1.3 (D50_CIPO), U1.6 (MISO)
unnamed: J1.4 (D51_COPI), U1.7 (MOSI)
unnamed: J1.5 (D52_SCK), U1.5 (SCK)
unnamed: J1.6 (D53_CS), U1.8 (CS)
unnamed: J1.33 (KIOSK), JP1.2 (C)
unnamed: J3.12, U3.13 (AREF/PA0)
unnamed: J5.5, J6.4
unnamed: R1.1, U3.2 (XTAL1/PB0)
