sanine-a/iowa-rover/kiosk/electronics/iowa-rover-kiosk-programmer/dna-puzzle-electronics.kicad_pcb

## KiCad design kiosk/electronics/iowa-rover-kiosk-programmer/dna-puzzle-electronics.kicad_pcb (2023-09-21)

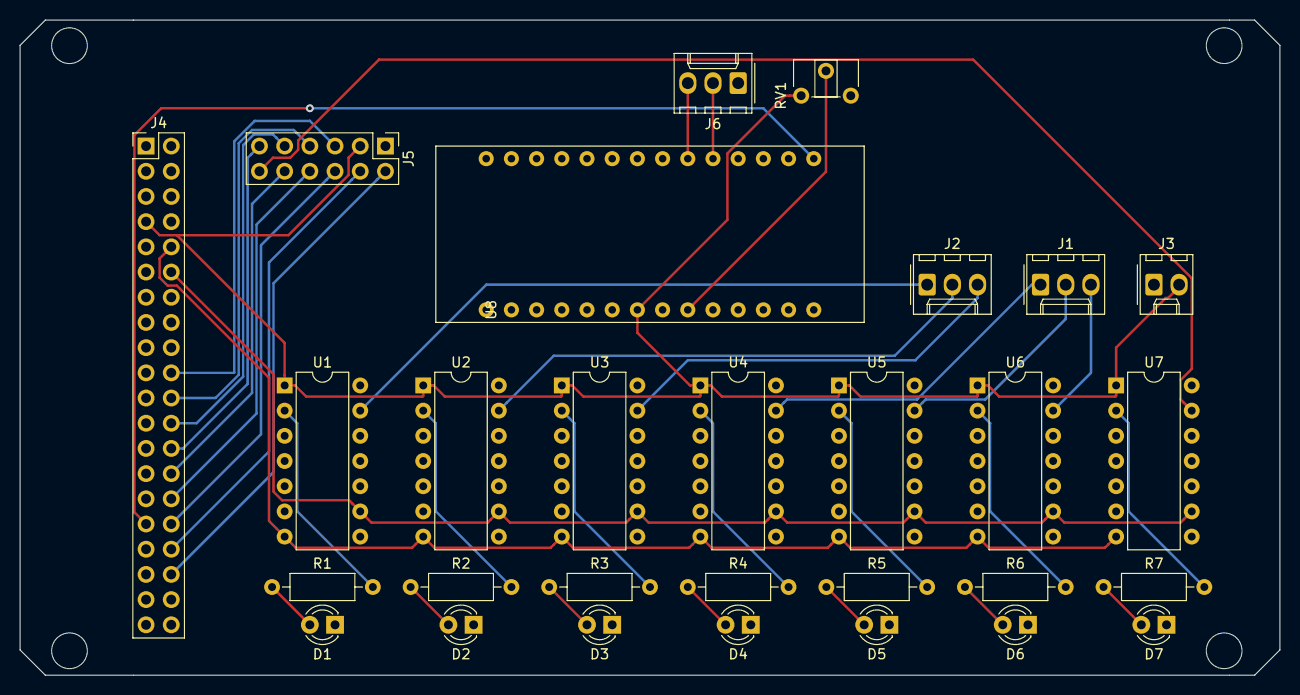
[picture p20: board dna-puzzle-electronics.kicad_pcb from above]

Board: 2 copper layers, 127.0 x 66.0 mm, 29 parts (0 on the bottom side), 38 nets.

Parts:
D1, D2, D3, D4, D5, D6, D7: LED; LED_D3.0mm
J1, J2, J6: Conn_01x03; Molex_KK-254_AE-6410-03A_1x03_P2.54mm_Vertical
J3: Conn_01x02; Molex_KK-254_AE-6410-02A_1x02_P2.54mm_Vertical
J4: SMM_Mega_Shield_Connector; PinHeader_2x20_P2.54mm_Vertical
J5: Conn_02x06_Odd_Even; PinHeader_2x06_P2.54mm_Vertical
R1, R2, R3, R4, R5, R6, R7: R; R_Axial_DIN0207_L6.3mm_D2.5mm_P10.16mm_Horizontal
RV1: R_POT; Potentiometer_ACP_CA6-H2,5_Horizontal
U1, U2, U3, U4, U5, U6, U7: ATtiny84-20PU; DIP-14_W7.62mm
U8: Adafruit_Metro_Mini; Metro-Mini

Connections:
+5V: J3.2, J4.7, J5.3, RV1.1, U1.1, U2.1, U3.1, U4.1, U5.1, U6.1, U7.1, U8.7
/RFID1: J2.1, U1.13
/RFID2: J2.2, U2.13
/RFID3: J2.3, U3.13
/RFID4: J1.1, U4.13
/RFID5: J1.2, U5.13
/RFID6: J1.3, U6.13
/SCL: J4.10, U1.7, U2.7, U3.7, U4.7, U5.7, U6.7, U7.7
/SDA: J4.12, U1.9, U2.9, U3.9, U4.9, U5.9, U6.9, U7.9
GND: D1.1, D2.1, D3.1, D4.1, D5.1, D6.1, D7.1, J3.1, J4.1, J5.1, J6.1, RV1.3, U1.14, U2.14, U3.14, U4.14, U5.14, U6.14, U7.14, U8.5
unnamed: D1.2, R1.1
unnamed: D2.2, R2.1
unnamed: D3.2, R3.1
unnamed: D4.2, R4.1
unnamed: D5.2, R5.1
unnamed: D6.2, R6.1
unnamed: D7.2, R7.1
unnamed: J4.20, J5.5
unnamed: J4.22, J5.7
unnamed: J4.24, J5.9
unnamed: J4.26, J5.11
unnamed: J4.28, J5.10
unnamed: J4.30, J5.8
unnamed: J4.31, U8.15
unnamed: J4.32, J5.6
unnamed: J4.34, J5.4
unnamed: J4.36, J5.2
unnamed: J5.12, U7.13
unnamed: J6.2, U8.19
unnamed: J6.3, U8.20
unnamed: R1.2, U1.2
unnamed: R2.2, U2.2
unnamed: R3.2, U3.2
unnamed: R4.2, U4.2
unnamed: R5.2, U5.2
unnamed: R6.2, U6.2
unnamed: R7.2, U7.2
unnamed: RV1.2, U8.9
