sanine-a/iowa-rover/kiosk/code/irkiosk-main/pins.h

#pragma once


// programmer board
#define PROG_BTN1 33
#define PROG_BTN2 34
#define PROG_BTN3 35
#define PROG_BTN4 36
#define PROG_BTN5 37

#define PROG_LED1 38
#define PROG_LED2 39
#define PROG_LED3 40
#define PROG_LED4 41


// radio
#define RADIO_CS 53
#define RADIO_INT 19
#define RADIO_RST 45


// neopixels
#define NEOPIXELS 6


// shift registers
#define SHIFT_DATA 12
#define SHIFT_CLOCK 10
#define SHIFT_LATCH 9


// buttons
#define UP1_BTN   22
#define DOWN1_BTN 23
#define UP2_BTN   24
#define DOWN2_BTN 25
#define UP3_BTN   29
#define DOWN3_BTN 28
#define UP4_BTN   27
#define DOWN4_BTN 26
#define TX_BTN    30


// kiosk select
#define KIOSK_SELECT 32
