sanine-a/iowa-rover/kiosk/code/irkiosk-main/slot.cpp

#include <Arduino.h>
#include "category.h"
#include "slot.h"
#include "pins.h"

// manage a single slot
SlotReader::SlotReader(
	Model& model, unsigned int commandIndex, Scheduler& sch, 
	Rfid& rfid, byte addr, 
	ShiftLamp& lamp,
	SlotButtons& slotButtons
) : 
	Subscriber<SlotButtonEvent>::Subscriber(&slotButtons),
	Subscriber<RfidEvent>::Subscriber(&rfid), 
	addr(addr),
	model(model), commandIndex(commandIndex), sch(sch), 
	lamp(lamp) {}


// update the slot command from RFID scans
void SlotReader::on(RfidEvent e) {
	if (e.sourceAddr != addr) { return; } // ignore messages not from the address we are interested in
	byte category = model.tbl.findTag(e.tag);
	if (category == CATEGORY_UNKNOWN) {
		// flash lamp twice to indicate unknown tag
		lamp.turnOn();
		sch.setTimeout([this]{
			lamp.turnOff(); sch.setTimeout([this]{
				lamp.turnOn(); sch.setTimeout([this]{
					lamp.turnOff();
				}, 500);
			}, 500);
		}, 500);
	} else if (model.commands[commandIndex].action == category) {
		// ignore duplicate scans	
		lamp.turnOn();
	} else {
		// briefly turn lamp off and then stay on to indicate the tag was scanned successfully
		model.commands[commandIndex].action = category;
		lamp.turnOff();
		sch.setTimeout([this]{
			lamp.turnOn();
		}, 200);
	}
}


// update the slot amount from SlotButtonEvents
void SlotReader::on(SlotButtonEvent e) {
	if (e.sourceSlot != commandIndex) { return; }
	if (e.btn == SlotButtonEvent::Button::PUSH_INCREMENT) {
		model.commands[commandIndex].amount += (1.0/8.0);
	} else if (e.btn == SlotButtonEvent::Button::PUSH_DECREMENT) {
		model.commands[commandIndex].amount -= (1.0/8.0);
	}

	if (model.commands[commandIndex].amount < 0) {
		model.commands[commandIndex].amount  = 0;
	}
	if (model.commands[commandIndex].amount > 1) {
		model.commands[commandIndex].amount  = 1;
	}
}


// check if the lamp should turn off
void SlotReader::update() {
	if (model.commands[commandIndex].action == Model::Command::Action::NONE) {
		lamp.turnOff();
	}
}


SlotButton::SlotButton(
	Model& model, Publisher<SlotButtonEvent> *publisher,
	unsigned int slotIndex, SlotButtonEvent::Button buttonType, 
	unsigned int buttonPin, ShiftLamp& lamp
) : 
	model(model), publisher(publisher),
	slotIndex(slotIndex), buttonType(buttonType), 
	PolledSwitch(buttonPin), lamp(lamp)
{}

// poll the slot button
void SlotButton::update() {
	PolledSwitch::update();
	if (model.commands[slotIndex].action != action) {
		action = model.commands[slotIndex].action;
		if (action == Model::Command::Action::NONE) {
			lamp.turnOff();
		} else {
			lamp.turnOn();
		}
	}
}

// cause the container SlotButtons struct to publish a SlotButtonEvent
void SlotButton::onLow() {
	if (action == Model::Command::Action::NONE) { return; } // ignore presses when the action is NONE
	struct SlotButtonEvent event = { slotIndex, buttonType };
	publisher->publish(event);
}
void SlotButton::onHigh() {}


SlotButtons::SlotButtons(Model& model, ShiftLamps& lamps) :
	inc1(model, this, 0, SlotButtonEvent::Button::PUSH_INCREMENT, UP1_BTN,   lamps.inc1),
	dec1(model, this, 0, SlotButtonEvent::Button::PUSH_DECREMENT, DOWN1_BTN, lamps.dec1),
	inc2(model, this, 1, SlotButtonEvent::Button::PUSH_INCREMENT, UP2_BTN,   lamps.inc2),
	dec2(model, this, 1, SlotButtonEvent::Button::PUSH_DECREMENT, DOWN2_BTN, lamps.dec2),
	inc3(model, this, 2, SlotButtonEvent::Button::PUSH_INCREMENT, UP3_BTN,   lamps.inc3),
	dec3(model, this, 2, SlotButtonEvent::Button::PUSH_DECREMENT, DOWN3_BTN, lamps.dec3),
	inc4(model, this, 3, SlotButtonEvent::Button::PUSH_INCREMENT, UP4_BTN,   lamps.inc4),
	dec4(model, this, 3, SlotButtonEvent::Button::PUSH_DECREMENT, DOWN4_BTN, lamps.dec4)
{}

// poll each SlotButton
void SlotButtons::update() {
	inc1.update(); dec1.update();
	inc2.update(); dec2.update();
	inc3.update(); dec3.update();
	inc4.update(); dec4.update();
}


SlotBarGraph::SlotBarGraph(Model& model, unsigned int slotIndex, Adafruit_NeoPixel& strip) :
	model(model), slotIndex(slotIndex), strip(strip) {}


// display the current command amount on the bar graph
void SlotBarGraph::update() {
	if (model.commands[slotIndex].action == Model::Command::Action::NONE) { 
		showAmount(0);
	} else {
		showAmount(8 * model.commands[slotIndex].amount);
	}
}

// display [amount] on the bar graph
void SlotBarGraph::showAmount(unsigned int amount) {
	auto color = strip.Color(0x1a, 0x18, 0x00);
	unsigned int offset = slotIndex * 8;
	for (int i=0; i<8; i++) {
		unsigned int px = i + offset;
		if (i < amount) {
			strip.setPixelColor(px, color);
		} else {
			strip.setPixelColor(px, strip.Color(0, 0, 0));
		}
	}
}

// clear a bar graph
void SlotBarGraph::clear() {
	showAmount(0);
}


SlotBarGraphs::SlotBarGraphs(Model& model) :
	strip(32, NEOPIXELS, NEO_GRB + NEO_KHZ800),
	bar1(model, 0, strip),
	bar2(model, 1, strip),
	bar3(model, 2, strip),
	bar4(model, 3, strip)
{
	strip.begin();
	strip.clear();
}


// update each bar graph
void SlotBarGraphs::update() {
	bar1.update();
	bar2.update();
	bar3.update();
	bar4.update();
	strip.show();
}
