sanine-a/iowa-rover/rover/code/ir-rover/pins.h

#pragma once

// radio module
#define RADIO_CS 4
#define RADIO_INT 3
#define RADIO_RST 2

// h-bridge
#define AIN1 7
#define AIN2 8
#define PWMA 5

#define BIN1 9
#define BIN2 10
#define PWMB 6

// configuration peripherals
#define TRIMPOT A0
#define KIOSK_SELECT A1
