sanine-a/iowa-rover/kiosk/code/irkiosk-main/sr_lamp.cpp

#include <Arduino.h>
#include "sr_lamp.h"
#include "pins.h"

#define OFFSET_BYTE(off) (off/8)
#define OFFSET_BIT(off)  (off%8)

ShiftRegisterPin::ShiftRegisterPin(byte* root, size_t offset)
: b(root + OFFSET_BYTE(offset)), pos(OFFSET_BIT(offset)) {}

// set the managed bit to 1
// returns true if the bit flipped, and false otherwise
bool ShiftRegisterPin::write1() {
	byte old = *b;
	*b |= 1 << pos;
	return old != *b;
}

// set the managed bit to 0
// returns true if the bit flipped, and false otherwise
bool ShiftRegisterPin::write0() {
	byte old = *b;
	*b &= ~(1 << pos);
	return old != *b;
}

// flips the managed bit
void ShiftRegisterPin::toggle() {
	*b ^= 1 << pos;
}


ShiftLamp::ShiftLamp(Scheduler& sch, ShiftLamps* lamps, size_t index) 
: sch(sch), lamps(lamps), ShiftRegisterPin(lamps->data, index) {}

// turn the lamp on
void ShiftLamp::turnOn() { 
	sch.clearInterval(flashInterval);
	if (write1()) { lamps->show(); } 
}
// turn the lamp off
void ShiftLamp::turnOff() { 
	sch.clearInterval(flashInterval);
	if (write0()) { lamps->show(); } 
}
// set the lamp to flash
// period is the length of the 50% duty cycle flashing
// duration is the length of time to flash for. if duration is zero, flash forever
void ShiftLamp::flash(unsigned int period, unsigned int duration) {
	sch.clearInterval(flashInterval);
	flashInterval = sch.setInterval([this] {
		toggle(); lamps->show();
	}, period/2);
	if (duration != 0) {
		sch.setTimeout([this] { turnOff(); }, duration);
	}
}


ShiftLamps::ShiftLamps() :
inc1(sch, this, 0), dec1(sch, this, 1),
inc2(sch, this, 3), dec2(sch, this, 2),
inc3(sch, this, 4), dec3(sch, this, 5),
inc4(sch, this, 6), dec4(sch, this, 7),

rfid1(sch, this, 8),
rfid2(sch, this, 9),
rfid3(sch, this, 11),
rfid4(sch, this, 10),

ready(sch, this, 12), error(sch, this, 13), 
running(sch, this, 14), txBtn(sch, this, 15) {
	pinMode(SHIFT_DATA, OUTPUT);
	pinMode(SHIFT_CLOCK, OUTPUT);
	pinMode(SHIFT_LATCH, OUTPUT);
	clear();
	show();
}


// clear all lamps
void ShiftLamps::clear() {
	memset(data, 0, sizeof(data));
}


// shift out the lamps
void ShiftLamps::show() {
	digitalWrite(SHIFT_LATCH, 0);
	shiftOut(SHIFT_DATA, SHIFT_CLOCK, MSBFIRST, data[1]);
	shiftOut(SHIFT_DATA, SHIFT_CLOCK, MSBFIRST, data[0]);
	digitalWrite(SHIFT_LATCH, 1);
}


// update the scheduler (to manage flashing intervals & timeouts)
void ShiftLamps::update() {
	sch.update();
}
