sanine-a/iowa-rover/kiosk/code/irkiosk-main/programmer_leds.h

#pragma once

#include "pins.h"
#include "scheduler.h"


namespace Programmer {
class Leds {
	public:
	Leds() : sch() {
		// initialize LED pins
		pinMode(PROG_LED1, OUTPUT);
		pinMode(PROG_LED2, OUTPUT);
		pinMode(PROG_LED3, OUTPUT);
		pinMode(PROG_LED4, OUTPUT);
		clearAll();

		// initialize interval indices
		for (int i=0; i<4; i++) { intervals[i] = -1; }
	}

	// light/flash/clear functions
	void lightForward()  { setFlashing(0, false); digitalWrite(PROG_LED1, 1); }
	void flashForward()  { setFlashing(0, true); }
	void clearForward()  { setFlashing(0, false); digitalWrite(PROG_LED1, 0); }

	void lightBackward() { setFlashing(1, false); digitalWrite(PROG_LED2, 1); }
	void flashBackward() { setFlashing(1, true); }
	void clearBackward() { setFlashing(1, false); digitalWrite(PROG_LED2, 0); }

	void lightLeft()     { setFlashing(2, false); digitalWrite(PROG_LED3, 1); }
	void flashLeft()     { setFlashing(2, true); }
	void clearLeft()     { setFlashing(2, false); digitalWrite(PROG_LED3, 0); }

	void lightRight()    { setFlashing(3, false); digitalWrite(PROG_LED4, 1); }
	void flashRight()    { setFlashing(3, true); }
	void clearRight()    { setFlashing(3, false); digitalWrite(PROG_LED4, 0); }

	void clearAll() {
		clearForward();
		clearBackward();
		clearLeft();
		clearRight();
	}
	void flashAll() {
		clearAll();
		for (int i=0; i<4; i++) { setFlashing(i, true); }
	}

	// needed to update the internal scheduler
	void update() {
		sch.update();
	}

	private:
	Scheduler sch;
	int intervals[4];

	// set whether a given LED is flashing
	void setFlashing(int index, bool flashing) {
		if (!flashing) {
			// clear the associated flashing interval
			sch.clearInterval(intervals[index]);
		} else {
			// set a new flashing interval
			switch(index) {
			case 0:
				intervals[0] = 
					sch.setInterval([]{ digitalWrite(PROG_LED1, !digitalRead(PROG_LED1)); }, 200);
				return;
			case 1:
				intervals[1] =
					sch.setInterval([]{ digitalWrite(PROG_LED2, !digitalRead(PROG_LED2)); }, 200);
				return;
			case 2:
				intervals[2] =
					sch.setInterval([]{ digitalWrite(PROG_LED3, !digitalRead(PROG_LED3)); }, 200);
				return;
			case 3:
				intervals[3] = 
					sch.setInterval([]{ digitalWrite(PROG_LED4, !digitalRead(PROG_LED4)); }, 200);
				return;
			default:
				return;
			}
		}
	}
};
} // end namespace Programmer
