sanine-a/iowa-rover/kiosk/code/irkiosk-main/scheduler.h

#pragma once

#include <Arduino.h>

#include "lambda.h"
#include "ll.h"

// parent struct representing a single scheduled lambda
struct Task {
	Lambda<void(void)> lambda;
	unsigned long start;
	unsigned int id;
	bool ready() { return millis() >= start; }
};

struct TimeoutTask : public Task {
};
struct IntervalTask : public Task {
	unsigned long interval;
	bool next() {
		start += interval;
	}
};


// class for javascript-style lambda scheduling
class Scheduler {
	public:
	Scheduler() : interval_id(0), timeout_id(0), intervals(), timeouts() {}

	// schedule a single task
	unsigned int setTimeout(Lambda<void(void)> lambda, unsigned long time_to_start) {
		TimeoutTask t;
		t.lambda = lambda;
		t.id = timeout_id;
		timeout_id++;
		t.start = millis() + time_to_start;
		timeouts.append(t);
		return t.id;
	}
	// remove a timeout from the scheduler
	// does nothing if no timeout matches the given id, so it can safely be called without
	// worrying if the timeout has executed already or not
	void clearTimeout(int id) {
		for (auto node = timeouts.get_next(); node != nullptr; node = node->get_next()) {
			if (node->get_value().id == id) {
				node->erase();
				return;
			}
		}
	}


	// schedule a repeating task
	unsigned int setInterval(Lambda<void(void)> lambda, unsigned long period) {
		IntervalTask i;
		i.lambda = lambda;
		i.id = interval_id;
		interval_id += 1;
		i.start = millis() + period;
		i.interval = period;
		intervals.append(i);
		return i.id;
	}
	// remove an interval from the scheduler
	// does nothing if no interval matches the given id
	void clearInterval(int id) {
		for (auto node = intervals.get_next(); node != nullptr; node = node->get_next()) {
			if (node->get_value().id == id) {
				node->erase();
				return;
			}
		}
	}

	// check which tasks are due to execute and then run them
	void update() {
		// check all scheduled intervals
		for (auto node = intervals.get_next(); node != nullptr; node = node->get_next()) {
			IntervalTask& interval = node->get_value();
			if (interval.ready()) {
				interval.lambda();
				interval.next(); // update interval time so that it will run again
			}
		}

		// check all scheduled timeouts
		for (auto node = timeouts.get_next(); node != nullptr; node = node->get_next()) {
			TimeoutTask& timeout = node->get_value();
			if (timeout.ready()) {
				timeout.lambda();
				node->erase(&node); // remove the interval from the scheduler
			}
		}
	}

	protected:
	LLNode<IntervalTask> intervals;
	size_t interval_id;
	LLNode<TimeoutTask> timeouts;
	size_t timeout_id;
};
