sanine-a/iowa-rover/kiosk/code/irkiosk-main/Rfid/HashSlot.h

#pragma once

#include <EEPROM.h>
#include "Tag.h"

#define FLAG_UNOCCUPIED 0x80
#define FLAG_DELETED  0x40
#define FLAG_CATEGORY 0x3f


// each slot is laid out in memory like this:
//
// flags tag0 tag1 tag2 tag3 tag4
//
// the first bit of the flags byte is 1 if the slot is unset (truly empty) and zero if it is set.
// the second bit is zero if the slot is deleted. deleted slots are treated as occupied during
// search but unoccupied during insertion.
// the 6 least significant bits of `flags` contain the category information for the tag.

struct HashSlot {
	unsigned int slot_index;

	unsigned int address() { return 6*slot_index; }

	// check if a slot is occupied
	// returns true if the cell is occupied AND undeleted when inserting
	// returns true if the cell is occupied even if deleted when searching
	bool isOccupied(bool searching) {
		uint8_t flag = EEPROM.read(address());
		if (flag & FLAG_UNOCCUPIED) {
			// the slot is unoccupied!
			return false;
		}

		if (!searching && (flag & FLAG_DELETED)) {
			return false;
		}

		return true;
	}

	bool isDeleted() {
		return EEPROM.read(address()) & FLAG_DELETED;
	}


	// get the category field of the flags byte
	uint8_t getCategory() {
		return EEPROM.read(address()) & FLAG_CATEGORY;
	}

	// set the category field of the flags byte
	void setCategory(uint8_t category) {
		EEPROM.update(address(), category & FLAG_CATEGORY);
	}

	// set the occupied bit of the flags byte
	void setOccupied(bool occupied) {
		unsigned int addr = address();
		uint8_t flag = EEPROM.read(addr);
		if (occupied) {
			EEPROM.update(addr, flag & (~FLAG_UNOCCUPIED));
		} else {
			EEPROM.update(addr, flag | FLAG_UNOCCUPIED);
		}
	}

	// set the deleted bit of the flags byte
	void setDeleted(bool deleted) {
		unsigned int addr = address();
		uint8_t flag = EEPROM.read(addr);
		if (deleted) {
			EEPROM.update(addr, flag | FLAG_DELETED);
		} else {
			EEPROM.update(addr, flag & (~FLAG_DELETED));
		}
	}


	// check if a slot matches a particular tag
	bool matchesTag(RfidTag tag) {
		unsigned int addr = address();
		for (int i=0; i<5; i++) {
			if (EEPROM.read(addr+i+1) != tag[i]) { return false; }
		}
		return true;
	}

	// set the tag
	void setTag(RfidTag tag) {
		unsigned int addr = address();
		for (int i=0; i<5; i++) {
			EEPROM.update(addr+i+1, tag[i]);
		}
	}

	// increment the slot index
	void increment(size_t tbl_size) {
		slot_index = (slot_index + 1) % tbl_size;
	}
};
