sanine-a/iowa-rover/(commit log)

2023-09-21 draw board
    [iowa-rover.kicad_pcb, iowa-rover.kicad_sch]
2023-09-21 generate gerbers
    [iowa-rover-B_Cu.gbl, iowa-rover-B_Mask.gbs, iowa-rover-B_Paste.gbp, iowa-rover-B_Silkscreen.gbo, iowa-rover-Edge_Cuts.gm1, iowa-rover-F_Cu.gtl, iowa-rover-F_Mask.gts, iowa-rover-F_Paste.gtp]
2023-09-21 add kiosk level buttons board
    [iowa-rover-kiosk-bargraph.kicad_pcb, iowa-rover-kiosk-bargraph.kicad_sch, iowa-rover-kiosk-level-buttons.kicad_pcb, iowa-rover-kiosk-level-buttons.kicad_sch]
2023-09-26 initial pass at board drawings
    [iowa-rover-kiosk-lamps.kicad_pcb, iowa-rover-kiosk-lamps.kicad_sch, iowa-rover-kiosk-level-buttons.kicad_pcb, iowa-rover-kiosk-level-buttons.kicad_sch, iowa-rover-kiosk-main.kicad_pcb, iowa-rover-kiosk-programmer.kicad_pcb, iowa-rover-kiosk-rfid.kicad_pcb, iowa-rover-kiosk-rfid.kicad_sch]
2023-09-28 fix sda/scl bus connections
    [iowa-rover-kiosk-rfid.kicad_pcb, iowa-rover-kiosk-rfid.kicad_sch]
2023-10-03 add gerbers and initial radio code
    [iowa-rover-B_Cu.gbl, iowa-rover-B_Mask.gbs, iowa-rover-B_Paste.gbp, iowa-rover-B_Silkscreen.gbo, iowa-rover-Edge_Cuts.gm1, iowa-rover-F_Cu.gtl, iowa-rover-F_Mask.gts, iowa-rover-F_Paste.gtp]
2023-10-03 fix bug with radio buffer length
    [ir-rover.ino, radioserial.h]
2023-10-04 update radio power and add electronics PDF and readme
    [iowa-rover.kicad_sch]
2023-10-04 remove schematics folder
    [iowa_rover_kiosk.kicad_pcb, iowa_rover_kiosk.kicad_sch]
2023-10-05 update board descriptions
2023-10-05 add pdf schematics
    [iowa-rover-kiosk-lamps.kicad_sch, iowa-rover-kiosk-level-buttons.kicad_sch, iowa-rover-kiosk-main.kicad_sch, iowa-rover-kiosk-mega-adapter.kicad_sch, iowa-rover-kiosk-programmer.kicad_sch, iowa-rover-kiosk-rfid.kicad_sch]
2023-10-17 implement programmer leds
2023-10-18 fix scheduler lambda usage and add programmer buttons
    [buttons.h, irkiosk-main.ino, lambda.h, leds.h, scheduler.h, signal.h]
2023-10-25 implement basic rfid read/command update/button lighting
2023-10-26 add power cycler for tag removal detection
    [iowa-rover-kiosk-power-cycler-B_Cu.gbl, iowa-rover-kiosk-power-cycler-B_Mask.gbs, iowa-rover-kiosk-power-cycler-B_Paste.gbp, iowa-rover-kiosk-power-cycler-B_Silkscreen.gbo, iowa-rover-kiosk-power-cycler-Edge_Cuts.gm1, iowa-rover-kiosk-power-cycler-F_Cu.gtl, iowa-rover-kiosk-power-cycler-F_Mask.gts, iowa-rover-kiosk-power-cycler-F_Paste.gtp]
2023-10-31 fix pin mapping
2023-11-01 implement transmit/ready lamp behavior and fix empty slot bug
    [mvc.cpp, slot.cpp, sr_lamp.cpp, sr_lamp.h, transmit.cpp, transmit.h]
